Escaper2/proect/термостат 2/библиотеки/README.txt

EE Concierge + Altium Library Install Instruction:

The following are the instructions for loading a library that was exported from EE Concierge into Altium.

The library will come as a zip file filled with all the necessary Altium data files required to load your EE Concierge parts into Altium. For every part there will be a pcb file, and a schematic file. There will also be an index file, a readme file, and finally the master library file itself. Do not try to open any of the individual part files, or the index file as they can't be loaded on their own.

Instead, to load a library you simply need to point Altium to this master library file named: 'EEConcierge.DbLib'. There are two ways to do this which we outline below. Whenever you need to load an updated version of your EE Concierge library the instructions are exactly the same. We've tagged the parts exports in such a way that Altium will overwrite and update any previously loaded parts as opposed to creating duplicates.

Method A:

1) Unzip the exported library
2) Double click on the file 'EEConcierge.DbLib'
3) Altium will open and load the library for you, you can now use your new components

Method B:

1) Unzip the exported library
2) Open Altium Designer
3) In the 'File' menu, click 'Open'
4) Browse to the unzipped library directory, select 'EEConcierge.DbLib' and click 'Open'

Altium will load the library, you can now use your new components
All parts exported succesfully.
