Escaper2/proect/термостат 2/библиотеки/db.xlsx

Library Ref | Library Path | Footprint Ref | Footprint Path | Datasheet Path | Capacitance | ComponentLink1Description | ComponentLink1URL | ComponentLink2Description | ComponentLink2URL | Datasheet Path | Description | Digikey Description | Digikey Part Number | Footprint Path | Footprint Ref | Inductance | Lead Free | Library Path | Library Ref | Manufacturer | Mouser Part Number | Package | Part Number | Price | Resistance | RoHS | Supplier 1 | Supplier 2 | Supplier Part Number 1 | Supplier Part Number 2 | Temperature | Temperature Range High | Temperature Range Low | Value | Voltage | helpURL
LM293D | parts/IC_Texas_Instruments_LM293D_eec.SchLib | Texas_Instruments_D_R-PDSO-G8_0 | parts/IC_Texas_Instruments_LM293D_eec_0.PcbLib | datasheets/IC_Texas_Instruments_LM293D_eec.pdf | SKIP | Upverter | https://upverter.com/upn/revision/0f7bdefa6904ade2/ | Datasheet | http://www.ti.com/lit/ds/symlink/lm293.pdf | datasheets/IC_Texas_Instruments_LM293D_eec.pdf | IC COMPARATOR DIFF DUAL 8SOIC | IC COMPARATOR DIFF DUAL 8SOIC | 296-9531-5-ND | parts/IC_Texas_Instruments_LM293D_eec_0.PcbLib | Texas_Instruments_D_R-PDSO-G8_0 | SKIP | yes | parts/IC_Texas_Instruments_LM293D_eec.SchLib | LM293D | Texas Instruments | 595-LM293D | D (R-PDSO-G8) | LM293D | SKIP | SKIP | TRUE | Digi-Key | Mouser | 296-9531-5-ND | 595-LM293D | -25°C to +85°C | +85°C | -25°C | SKIP | 18V | https://upverter.com/upn/revision/0f7bdefa6904ade2/
