Escaper2/proect/термостат 2/библиотеки/parts/IC_Texas_Instruments_LM293D_eec.STEP

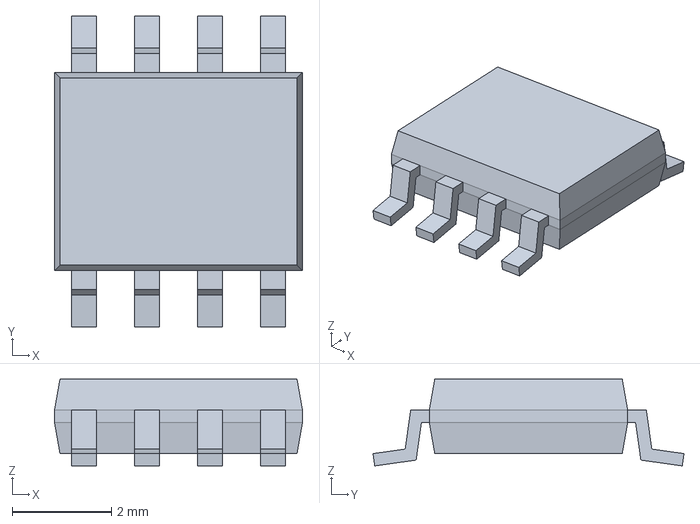
[picture p10: CAD file, 2020-03-28]
термостат 2/библиотеки/parts/IC_Texas_Instruments_LM293D_eec.STEP
5.00 x 6.27 x 1.75 mm
