Escaper2/proect/термостат 2/библиотеки/STEP/SOT108-1.step

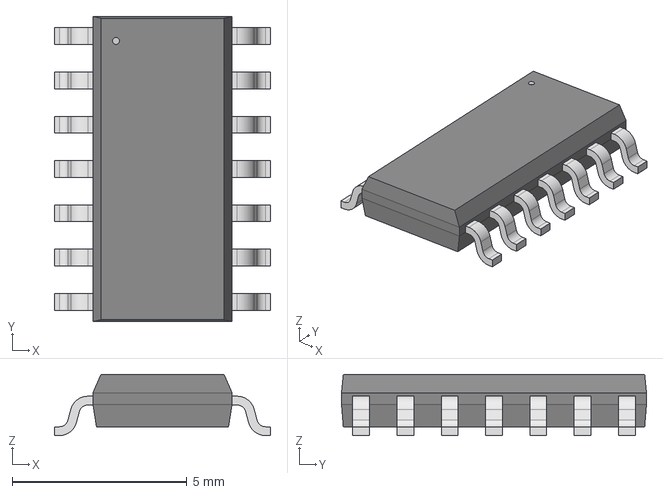
[picture p11: CAD file, 2020-03-28]
термостат 2/библиотеки/STEP/SOT108-1.step
6.20 x 8.74 x 1.75 mm
