Escaper2/proect/(list of files, cad)

Other CAD files:
термостат 2/библиотеки/STEP/SOT108-1-L.step
термостат 2/библиотеки/STEP/SOT108-1-M.step
