Escaper2/proect/(list of files, drawings)

Other design files:
термостат 2/PCB2.PcbDoc
термостат 2/PCB_Project_4.PrjPcb
термостат 2/Sheet1.SchDoc
термостат 2/библиотеки/2019-06-16_18-09-46.PcbLib
термостат 2/библиотеки/2019-06-16_18-09-46.SchLib
термостат 2/библиотеки/Miscellaneous Devices.PcbLib
термостат 2/библиотеки/Miscellaneous Devices.SchLib
термостат 2/библиотеки/Motor.PcbLib
термостат 2/библиотеки/Motor.~(2).SchLib
термостат 2/библиотеки/parts/IC_Texas_Instruments_LM293D_eec.SchLib
термостат 2/библиотеки/parts/IC_Texas_Instruments_LM293D_eec_0.PcbLib
термостат 2/библиотеки/TI_National_Semiconductor_LM56BIM_NOPB.SchLib
термостат 2/библиотеки/TI_National_Semiconductor_LM56BIM_NOPB_0.PcbLib
